omerkilic-0/akilli_sera/README.md

# Akıllı Sera

Bu proje 2023-2024 yılında Tavşanlı MYO Bilgisayar Programcılığı Programı Mikroişlemciler dersin Kadir Ocak, Ömer Kılıç ve Kerim Sarı isimli 3 öğrenci tarafından geliştirilmiştir. 

Proje temel olarak elektrik ihtiyacını güneş paneli sayesinde yenilenebilir enerjiden sağlayarak çalışmakta olup, sulama ve havalandırma işlemlerini tamamen otonom olarak gerçekleştirebilmektedir. Aynı zamanda geliştirilen Mobil Uygulama sayesinden canlı veriler görüntülenebilir ve sera kontrol edilebilir durumda olacaktır.

# Projeyi Hayata Geçirme

Gerekli olan komponentleri tedarik ettikten sonra adımları takip ederek projeyi çalışabilir hale getirebilirsiniz.

## 1. Adım - Komponentler

### Kullanılan Teknolojiler

**İstemci:** Arduino Ekosistemi, ESP32 geliştirme kartı

**Sunucu:** FireBase, MIT APP INVENTOR

## Komponentler

- Ardunio UNO
- 2x16 LCD Ekran
- Mini Dalgıç Su Pompası
- DHT11 Sıcaklık ve Nem Sensörü
- Toprak Nem Sensörü | 2 adet
- BradeBorad | Orta Boy
- ESP32 wroom | Dev Modül
- 10K Potansiyometre
- Ortec 25W Güneş Paneli
- Akü Şarj Cihazı PWM Marka
- 12V 7A Akü
- Erkek-Erkek Jumper | 40 Adet
- Dişi-Dişi Jumper | 40 Adet
- Dişi-Erkek Jumper | 80 Adet
- 10K Direnç | 10 Adet
- LDR Işık Sensörü
- Push Buton | 3 Adet
- Switch Buton | 2 Adet
- 5V Röle | 3 Adet
- Buzzer
- Kırmızı LED
- Fan
- UV LED
- Şipşak Anahtar
- Su Hortumu
- Kablo Kanalı | 35cm
- Lehim Teli
- Havya
- 
## 2. Adım - Devreyi Kurma

Devre şemasına bağlı kalarak devreyi kurun. Kırmızı renk (+) ve siyah renk (-)' yi temsil etmektedir.



## 3. Adım - FireBase' yi oluşturun

Gösterildiği dizinde Web API' nizi oluşturun.

```
FireBase
├── bMod
├── dDOrani
├── fan
├── gMiktari
├── hIsisi
├── hINem
├── kontrol
├── led
├── sDurumu
└── tNOrani
```



## 4. Adım - Kodu Yazma

FireBase nizi oluşturduktan sonra ESP32 kodu üzerinde "..." olarak bırakılan bölgeye WİFİ adı ve Şifreiniz daha sonra FireBase URL ve Şifrenizi yazın.

Arduino yu bilgisayrınıza bağladıktan Arduino İde aracılığı ile Board ve Port ayarlarını yaparak arduino.ino kodunu yazın.

ESP32 yi bilgisayrınıza bağladıktan sonra Arduino İde aracılığı ile gerekli Driverleri kurduktan sonra Board ve Port ayarlarını yaparak esp32.ino kodunu yazın.

## 5. Adım - Mobil Uygulamayı Hazırlama

MIT APP Inventor ile hazırlamış olduğumuz Mobil Uygulamamızın görselleri alt kısımda bulunmaktadır. Kendi zevkinize göre tasarlayabilir veya mobil.apk dosyası üzerinden uygulamamıza göz atabilirsiniz.

### Açılış Sayfası



### Ana Sayfa



### Kontrol Paneli



# Kapanış

Tebrikler. Tüm adımları uyguladınız ve Akıllı Seranız aktif olarak çalışmaktadır. Fakat bu projenin konsept bir proje olduğu unutulmamalı ve geliştirilebilecek birçok noktası bulunduğunu unutmayın. Eğer projemize katkıda bulunur iseniz çok sevinizir.

## Sera Genel Görüntüsü


## Küç Kaynağı Sistemi



## Sensörler ve Motorlar





## Kontrol Paneli




## geliştirilebilecek Noktalar

- Mobil Uygulama ile sera yönetim işlemleri eklenebilir. 
- Seranın veya Mobil Uygulamanın UI ve UX geliştirilmesi yapılabilir.
