omerkilic-0/akilli_sera/Akıllı Sera Proje Raporu.pdf

Kerim SARI | Ömer KILIÇ | Kadir OCAK

Akıllı Sera

# Proje Adı

## Akıllı Sera

# Takım Adı

## KÖK

# Takım Üyeleri

| | ADI | SOYADI | E-POSTA ADRESİ | Öğrenci No
1 | Takım Lideri | Kerim | Sarı | kerim.sari0@ogr.dpu.edu.tr | 202233521005
2 | Takım Üyesi | Ömer | Kılıç | omer.kilic5@ogr.dpu.edu.tr | 202233521028
3 | Takım Üyesi | Kadir | Ocak | kadir.ocak@ogr.dpu.edu.tr | 202233521040

## İçindekiler

# Giriş

Bu proje 2023-2024 eğitim yılında Tavşanlı MYO Bilgisayar Programcılığı Programı Mikroişlemciler dersinde 3 öğrencisi tarafından geliştirilmiştir.
“Akıllı Sera” isimli projemizin temel amacı ekosistem içerisinde bulunan sensörler aracılığı ile ölçümleri otomatik şekilde gerçekleştirerek sulama ve havalandırma işlemlerini otomatik olarak gerçekleştiren, kontrol paneli aracılığı ile kontrollerin yapıldığı ve aynı zamanda geliştirilen mobil uygulama tarafından sera ve bitki durumlarını anlık ve canlı olarak görüntüleyebilecek ve yönetebilecektir. Aynı zamanda yönetim sisteminde bulunan akü, akü şarj cihazı ve güneş paneli sayesinde ihtiyacı olan tüm elektrik gücünü kendisi oluşturarak maliyet azaltma ve karbon ayak izini azaltma gibi küresel problemlere de uyum sağlamaktadır.
Proje geliştirmesinde genel bir görev dağılımı yapılmış olsa da süreç içerisinde çoğu çalışma toplu olarak yapılmıştır.
Projeyi hayata geçirmek için 12. sayfada bulunan “Proje Uygulama” Başlığında verilen GitHub reposuna göz atabilirsiniz.

# Görev Dağılımı

Ömer Kılıç | Arduino ve ESP32 kodlaması(Fiziksel Geliştirme)
Kerim Sarı | Güneş Paneli ve Akü Bağlantıları, Mobil Uygulama Tasarımı ve Kodlaması
Kadir Ocak | Literatür Araştırmaları, Malzeme tedariği ve Rapor Yazımı

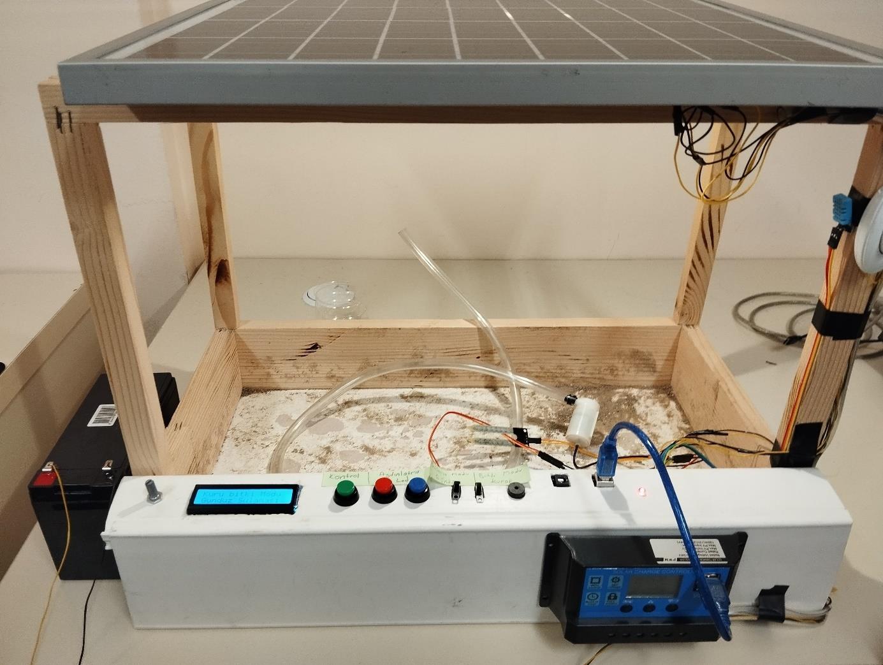
[picture p1: figure]

Sera Görseli

# 4.Hafta

Proje konusunun belirlenmesi ile birlikte kaynakça olabilecek ve yol gösterebilecek projeler aramaya ve incelemeye başladık.

## Bağlantılar

- https://www.instructables.com/WATERING-SYSTEM-INTRODUCTION/
- https://www.youtube.com/watch?v=Wx1Vi0EPhQU
- https://www.youtube.com/watch?v=kue2ZfBctPs&t=1049s
- https://www.youtube.com/watch?v=j9KcTOzwV3s
- https://www.youtube.com/watch?v=gD8AJ-uuhNI
- https://www.youtube.com/watch?v=817StfP5-Lc
- https://www.youtube.com/watch?v=827kfpfIoNA
- https://www.youtube.com/watch?v=JCN8QED31VQ
- https://www.youtube.com/watch?v=nU0ATB06-mQ&t=370s
- https://www.youtube.com/watch?v=70S4YRyMYgo
Araştırmalarımız ve hevesimiz sonucunda akıllı sera projesi yapmaya karar verdik.

# 5.Hafta

Araştırmalarımız sonucunda hangi kaynakça ile yola çıkacağımıza karar verdik.
- https://www.youtube.com/watch?v=kue2ZfBctPs&t=1049s
- https://maker.robotistan.com/arduino-ile-otomatik-sera/

## Malzeme Listesi

- Arduino UNO R3 Klon
- 2x16 LCD Ekran
- Mini Dalgıç Su Pompası 6v
- 2 kanal 2v Röle Kartı
- Su Seviyesi/Yağmur Sensörü
- DHT11 Sıcaklık ve Nem Sensörü
- Toprak Nemi Algılama Sensörü
- 80x80x25mm fan
- IRFZ44 – 49A 55V Mosfet
- IC205 180 Derece Sürgülü Siviç
- IC177 Mavi Push Buton
- 10mm LDR
- 10K Direnç
- 10k Potansiyometre

## Bağlantı Şeması

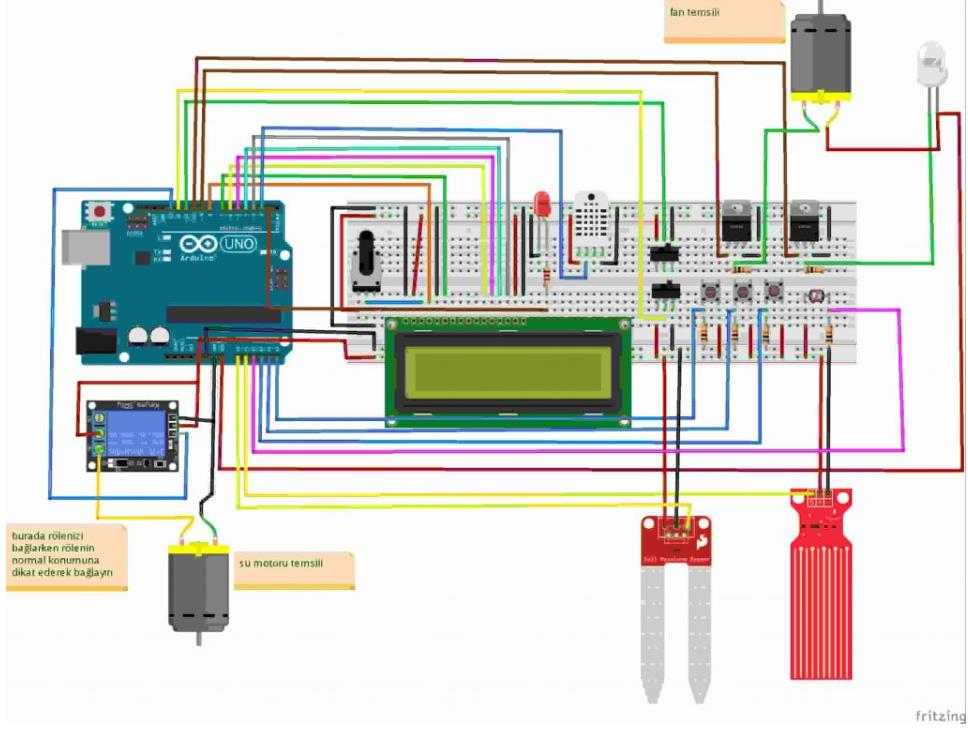
[picture p2: figure]

Proje tanıtım videosu ve dokümanında istenen tüm malzemeler tedarik etmeye başladık.

# 6.Hafta

Kaynakçada istenen tüm komponentler tedarik edildikten sonra dokümanda paylaşıldığı şemaya uyarak devreyi kurduk. Pin bağlantılarını doğru yaptığımızdan emin olduktan sonra paylaşılan kodu Arduino UNO ya yükledik. Hem fiziki hem de Serial Port aracılığı ile testlere başladık. Denemeler esnasında devrenin video anlatıldığı gibi çalışmadığını görerek sorunu aramaya başladık. Sorunun Mosfet ve Rölenin bağlantı ve kullanımında olduğunu düşünerek devreyi elden geçirmeye karar verdik.
Aynı zamanda seramızın kendi elektrik ihtiyacını kendisi karşılamasını istediğimiz için Panel, Akü Şarj Cihazı ve Akü araştırmaya başladık. Araştırmalarımız sonucunda 25W Güneş Paneli, 12V-24V 10A Akü Şarj Cihazı ve 12V 7A Akü kullanma kararı aldık.

## Elektrik Komponentleri

- https://www.n11.com/urun/ortec-gunes-paneli-25-watt-solar-panel-4064374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 (https://www.n11.com/urun/ortec-gunes-paneli-25-watt-solar-panel-4064374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)
- https://www.n11.com/urun/solar-gunes-paneli-aku-sarj-kontrol-cihazi-10-amper-12v-24v-4064413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 (https://www.n11.com/urun/solar-gunes-paneli-aku-sarj-kontrol-cihazi-10-amper-12v-24v-4064413)
- https://www.n11.com/urun/ttec-12-volt-7-a-aku-12v-7-ah-kuru-base-aku-haziran-2023-uretim-8334219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 (https://www.n11.com/urun/ttec-12-volt-7-a-aku-12v-7-ah-kuru-base-aku-haziran-2023-uretim-8334219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)

İhtiyacımız olan komponentleri tedarik etmeye başladık.

# 7.Hafta

Hata ile karşılaşmamız sonucunda tekrar araştırma ve planlamalar başladık. İlk önce hangi özellikleri ve sensörleri kullanmak istediğimize karar verdik.

## Yapmak İstediğimiz Özellikler

- Su deposunun doluluk oranını görüntüleme ve takip etme
- Toprak nem miktarını görüntüleme ve takip etme
- Hava ısı durumunu görüntüleme ve takip etme
- Hava nem durumunu görüntüleme ve takip etme
- Havalandırma için 2 adet fan çalıştırma
- Güneş ışığı miktarını takip etme
- Led iç aydınlatma
- LCD ekran da uyarı ve güncel bilgilerin görüntülenmesi
- Fiziki kontrol paneli aracılığı ile sera kontrolü
- Mobil uygulama ile güncel durum görüntüleme ve sera yönetimi

## Kullanmayı Planladığımız Sensörler ve Bileşenler

- DHT11 Isı ve Nem Sensörü
- LDR Işık Sensörü
- Toprak Nem Sensörü
- Yükseltici Modül Kartı
- Röle
- LCD Ekran
- Potansiyometre
- 3 Adet Push Buton
- 2 Adet Switch Buton
- 1 Adet Buzzer
- 1 Adet Kırmızı Led
- Arduino UNO R3
- BradeBoard
- Jumper türleri
Eksik olan komponentleri tedarik etmeye başladık.

# 10. Hafta

Eksik malzemelerimizin tamamlanması ile devreyi yeniden kurduk ve Mosfet yerine Röle, 1 fan yerine 2 fan ve farklı bir led ile bağlantılarımızı değiştirdik.

## Devremizin Pin Şeması

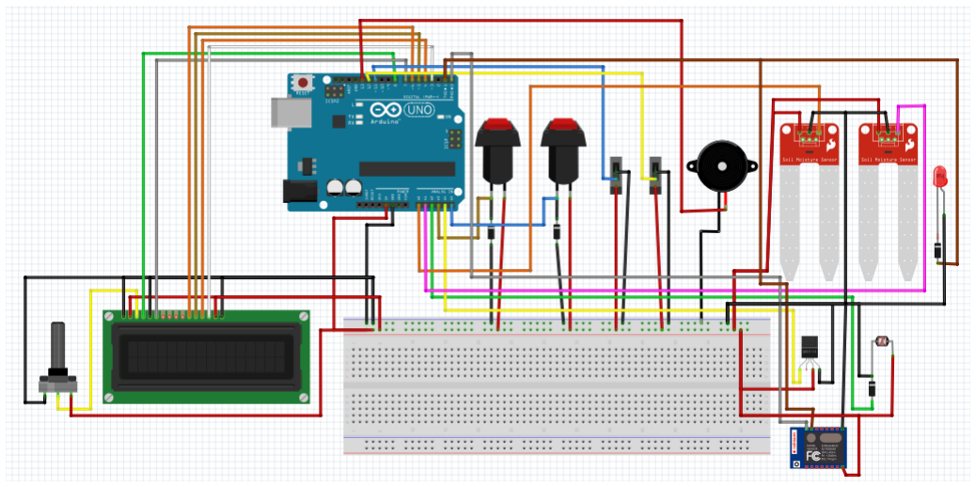
[picture p3: figure]

Devreyi kurduktan sonra planladığımız devre kutusunun içerisine yerleştirmeye başladık ve seranın kontrol panelini oluşturmuş olduk. Kaynakçada paylaşılan kodu düzenleyerek sistemi çalışır hale getirdik. Ardından seranın otomasyon işlemlerinin olmasını istediğimiz için yeni akış diyagramını kurmaya başladık.

## Akış Diyagramı

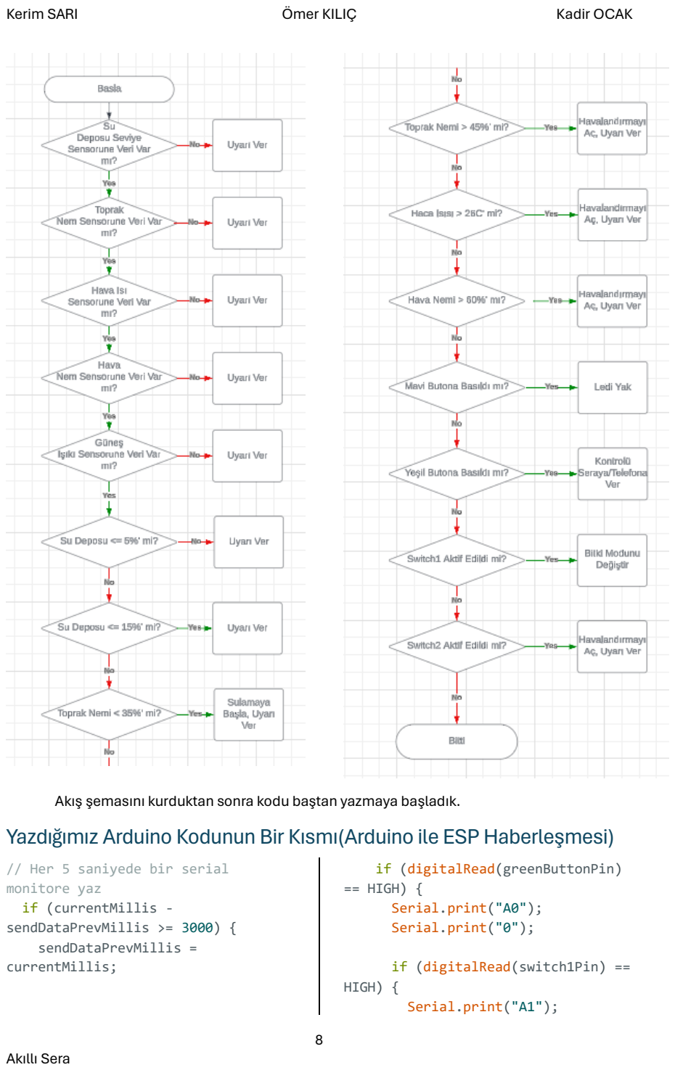
[picture p4: page 8]

Akış şemasını kurduktan sonra kodu baştan yazmaya başladık.

## Yazdığımız Arduino Kodunun Bir Kısmı(Arduino ile ESP Haberleşmesi)

// Her 5 saniyede bir serial
monitore yaz
if (currentMillis -
sendDataPrevMillis >= 3000) { sendDataPrevMillis =
currentMillis;

if (digitalRead(greenButtonPin) == HIGH) {
Serial.print("A0");
Serial.print("0");

if (digitalRead(switch1Pin) == HIGH) {
Serial.print("A1");

Serial.print("0");
} else {
Serial.print("A1");
Serial.print("1");
}

if (digitalRead(switch2Pin) == HIGH) {
Serial.print("A2");
Serial.print("0");
} else {
Serial.print("A2");
Serial.print("1");
}
} else {
Serial.print("A0");
Serial.print("1");

if (digitalRead(switch1Pin) == HIGH) {
Serial.print("A1");
Serial.print("0");
} else {
Serial.print("A1");
Serial.print("1");
}

if (digitalRead(switch2Pin) == HIGH) {
Serial.print("A2");
Serial.print("0");
} else {
Serial.print("A2");
Serial.print("1");
}
}

Serial.print("A3");
if (waterTankLevel < 10) { Serial.print("0");
}
Serial.print(waterTankLevel); Serial.print("A4");
if (soilMoisture < 10) {
Serial.print("0");
}
Serial.print(soilMoisture); Serial.print("A5");
Serial.print(temperature); Serial.print("A6");
Serial.print(humidity);
Serial.print("A7");
Serial.print(sunlight);
Serial.println("A8");
}

Kod yazma aşamasında yazdığımız kodun Arduino ya yüklendiğinde çalışmama hatası ile karşılaştık. Uzun uğraşlar sonucu yazdığımız kodun 600 satırdan fazla olmasıyla birlikte Arduino UNO’ nun dinamik belleğinin yetersiz gelme hatası ile karşılaştık. Yazdığımız kodu iyileştirerek hatayı çözerek geliştirmelerimize devam ettik.

## Hata Çıktısı

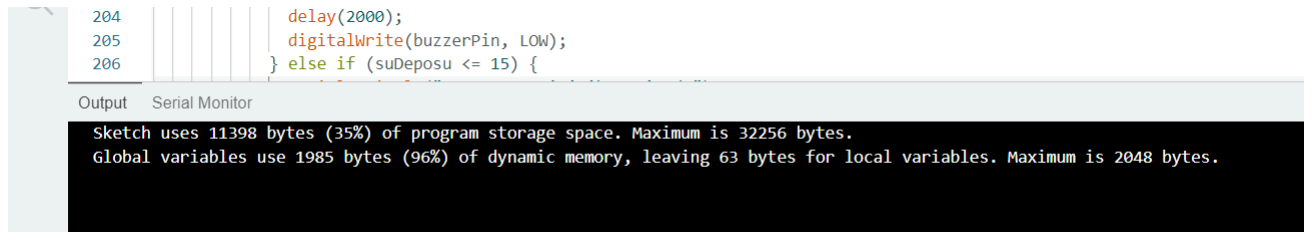
[picture p5: figure]

## Hatanın Çözümünden Sonraki Çıktı

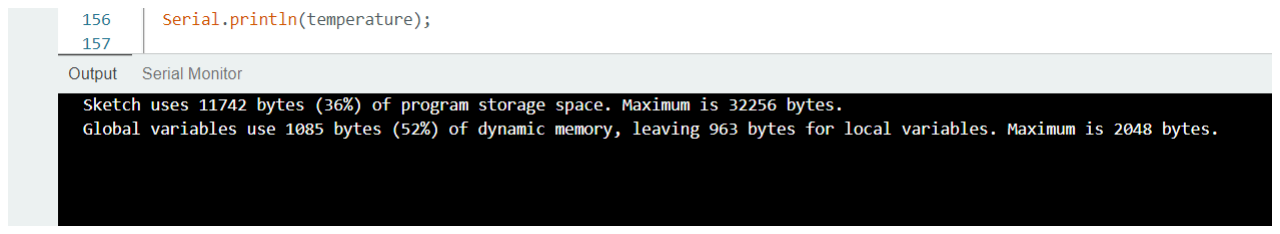
[picture p6: figure]

# 11. Hafta

Kurduğumuz devrenin ve yazdığımız Arduino kodunun fiziki ve Serial Port testlerini gerçekleştirerek devrenin ve kurduğumuz akış diyagramı doğrultusunda yazdığımız kodun çalıştığından emin olduk.
Aldığımız elektrik komponentlerini elimize ulaşması ile bağlantıları gerçekleştirerek Güneş Paneli, Akü Şarj Cihazı ve Akümüzü aktif hale getirerek tüm devrenin güneş enerjisi ile çalışmasını sağladık.
Sera sisteminin tamamlanması ile sıra mobil uygulama ile anlık bilgi görme ve serayı yönetmeye geldi. Önceden planlayarak tedarik ettiğimiz ESP32 kartını nasıl kullanacağımıza, pin bağlantılarına ve kod araştırmaları yapmaya başladık.

# 12. Hafta

Araştırmalarımız sonucunda ESP32 yi nasıl kullanabileceğimize karar verdikten sonra kodlamaya başladık. Arduino ile ESP32 ni RX ve TX pinlerini birbirlerine ters bağlayarak geliştirme kartlarını seri bağlamış olduk. ESP32 nin 5V ve GND pinlerini de Arduino ile bağlamamızın ardından kart bağlantıları tamamlanmış oldu. Serial monitör aracılığı ile Arduino UNO dan aldığımız verileri 3 saniyede bir FireBaseye yazdırmaya başladık.

## ESP32 Kodunun Bir Kısmı

if (Serial.available()) {
String message = Serial.readString();
int startPos = 0;
int endPos = message.indexOf("A", startPos + 1);

while (endPos != -1) {
String subMessage = message.substring(startPos, endPos); String key;
String valueStr;

if (subMessage.startsWith("A0")) {
key = "kontrol";
valueStr = subMessage.substring(2);
} else if (subMessage.startsWith("A1")) { key = "bMod";
valueStr = subMessage.substring(2);
} else if (subMessage.startsWith("A2")) {

key = "sDurumu";
valueStr = subMessage.substring(2);
} else if (subMessage.startsWith("A3")) { key = "dDOrani";
valueStr = subMessage.substring(2);
} else if (subMessage.startsWith("A4")) { key = "tNOrani";
valueStr = subMessage.substring(2);
} else if (subMessage.startsWith("A5")) { key = "hIsisi";
valueStr = subMessage.substring(2);
} else if (subMessage.startsWith("A6")) { key = "hNem";
valueStr = subMessage.substring(2);
} else if (subMessage.startsWith("A7")) { key = "gMiktari";
valueStr = subMessage.substring(2);
}

if (key.length() > 0) {
int valueInt = valueStr.toInt(); // Convert to integer to remove leading zeros
String path = "/realValue/" + key;
if (!Firebase.RTDB.setInt(&fbdo, path.c_str(), valueInt)) { Serial.printf("Error setting %s: %s\n", key.c_str(), fbdo.errorReason().c_str()); }
}
startPos = endPos;
endPos = message.indexOf("A", startPos + 1); }
}

Kod yazma işlemleri bittikten sonra MIT APP Inventor ile mobil uygulamamızı tasarlamaya başladık.

# 13. Hafta

Mobil uygulamamızın tasarımını ve kodlamasını yaptıktan sonra telefon ile yönetim platformu tamamlanmış oldu. Fakat ESP32 ile FireBase ye veri yazma ve veri çekme işlemleri sırasında çekilen verileri Serial Monitor aracılığı ile ESP32 ye aktarırken birçok hata ile karşılaştık. Hatalardan bahsetmek gerekir ise alınan ve gönderilen verilerin çakışması sonucu kodun kısır döngüye girmesi, ESP32 nin stabil olarak yazma ve okuma işlemleri yapamaması ve FireBase nin
3. Taraf bağlantılara engel atması sonucunda mobil uygulamamamızın sadece anlık bilgi görme kısımlarını tamamlamaya ve testlim etmeye karar verdik.

# Projeyi Uygulama

Projeyi kurmak için GitHub üzerindeki readme dosyası üzerinden ve kodlardan detaylara ulaşabilirsiniz.
- https://github.com/omerkilic-0/akilli_sera

# Kullanılan Tüm Komponentler

No | İsim | Adet | Alınan Yer | Ücret
1 | Arduino Uno | 1 | Bahadır Çokçetin | 0
2 | 2x16 lcd ekran | 1 | Bahadır Çokçetin | 0
3 | mini dalgıç pompa 6v | 1 | Bahadır Çokçetin | 0
4 | DHT11Sıcaklık ve nem sensörü | 1 | Bahadır Çokçetin | 0
5 | toprak nemi algılama sensörü | 1 | Bahadır Çokçetin | 0
6 | BreadBoard | 1 | Bahadır Çokçetin | 0
7 | ESP32 | 1 | Bahadır Çokçetin | 0
8 | Potansiyo Metre | 1 | Bahadır Çokçetin | 0
9 | Ortec 25W Güneş Paneli | 1 | N11 | 783
10 | Akü Şarj Cihazı | 1 | N11 | 300
11 | 12V 7A Akü | 1 | N11 | 395
12 | Erkek-Erkek Jumper | 40 | Robo90 | 26
13 | Dişi-Dişi Jumper | 40 | Robo90 | 24
14 | 10K Direnç | 10 | Robo90 | 2
15 | LDR | 2 | Robo90 | 2
16 | Push Buton | 3 | Robo90 | 27
17 | Switch | 2 | Robo90 | 5
18 | Mosfet | 2 | Robo90 | 20
19 | 5V Röle | 1 | Robo90 | 48
20 | Toprak Nem Sensörü | 1 | Robo90 | 24
21 | Dişi-Erkek Jumper | 80 | Robo90 | 50
22 | Buzzer | 1 | Robo90 | 6
23 | Kırmızı Led | 1 | Robo90 | 3
24 | Fan | 2 | Tavşanlı | 30
25 | LED | 1 | Tavşanlı | 45
27 | Şipşak Anahtar | 1 | Tavşanlı | 15
28 | Elektrik Bandı | 1 | Tavşanlı | 15
29 | Su Hortumu | 1 | Tavşanlı | 15
30 | Kablo Kanalı | 1 | Tavşanlı | 40
31 | Elektrik Kablosu | 1 | Tavşanlı | 15
32 | Lehim Teli | 1 | Robotistan | 22
33 | Kargo | 1 | | 45

## Toplam Fiyat: 1957 TL

# Sera Görselleri

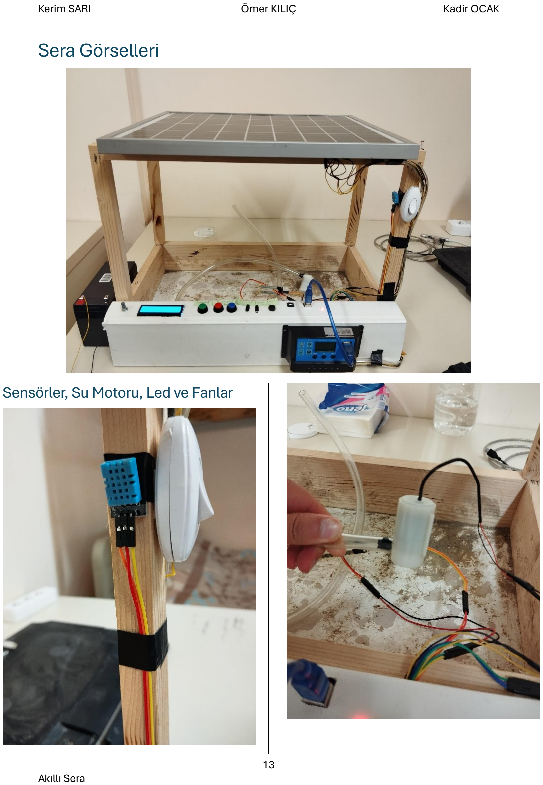
[picture p7: page 13]

## Sensörler, Su Motoru, Led ve Fanlar

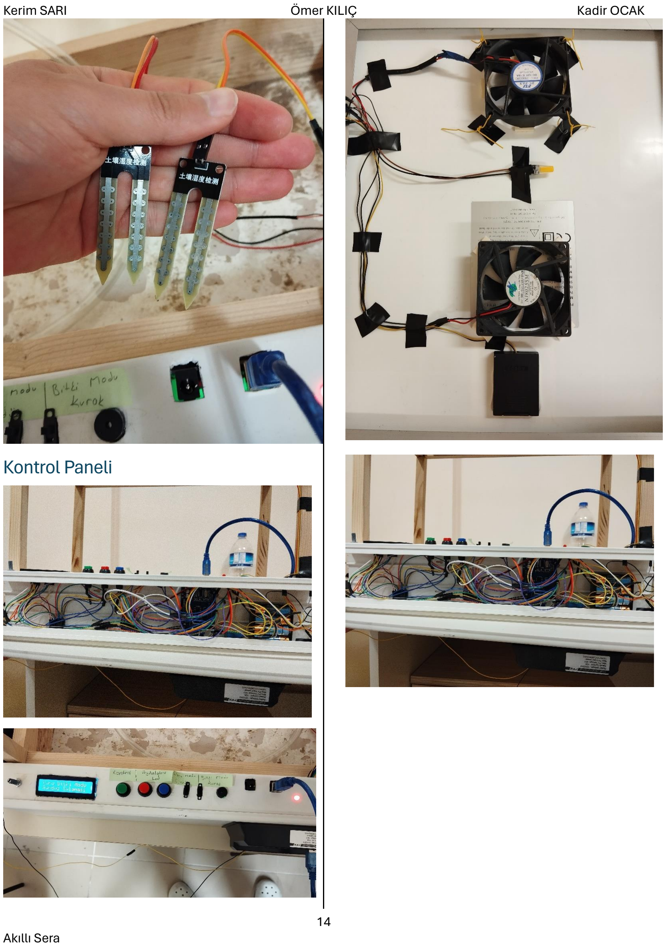
[picture p8: page 14]

## Kontrol Paneli

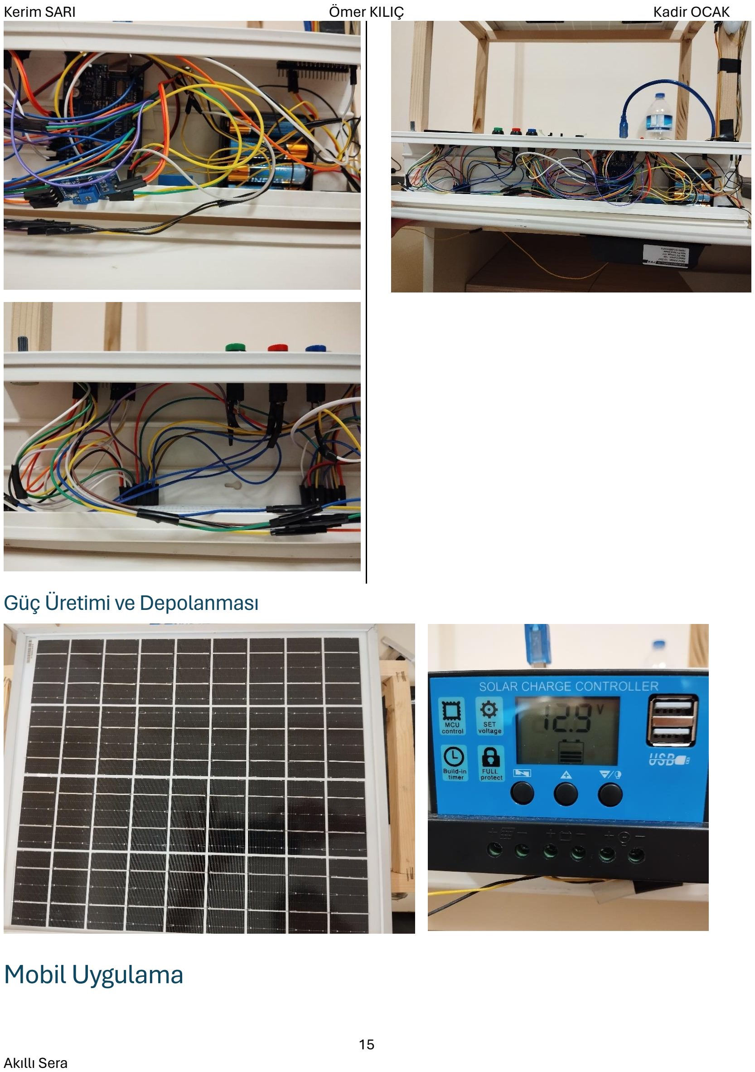
[picture p9: page 15]

## Güç Üretimi ve Depolanması

# Mobil Uygulama

## Arayüz

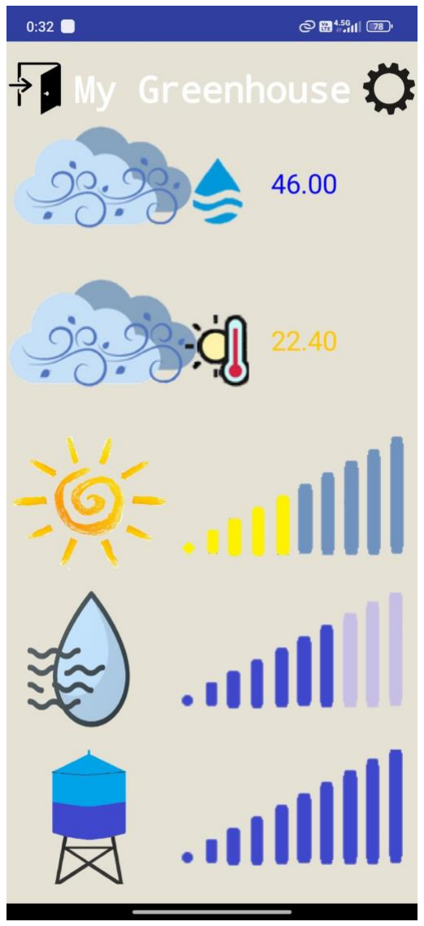
[picture p10: figure]
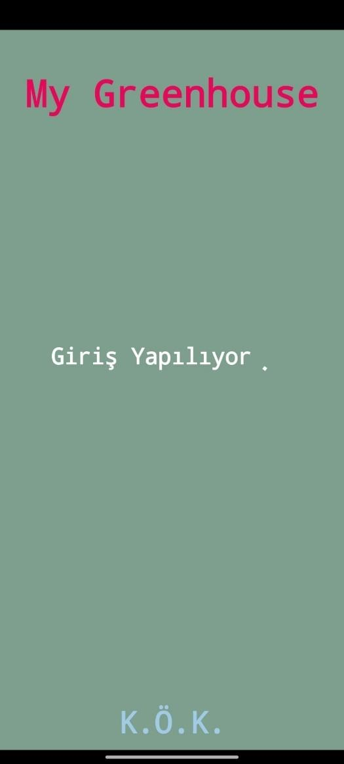
[picture p11: figure]

Giriş Sayfası | Ana Sayfa

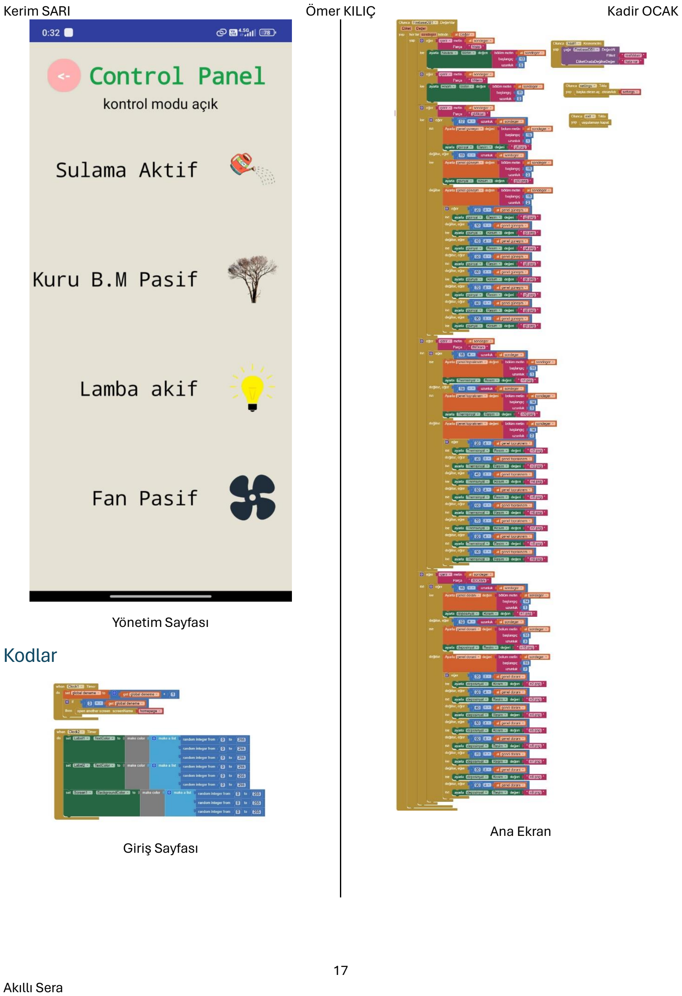
[picture p12: page 17]

Yönetim Sayfası

## Kodlar

Giriş Sayfası

Ana Ekran

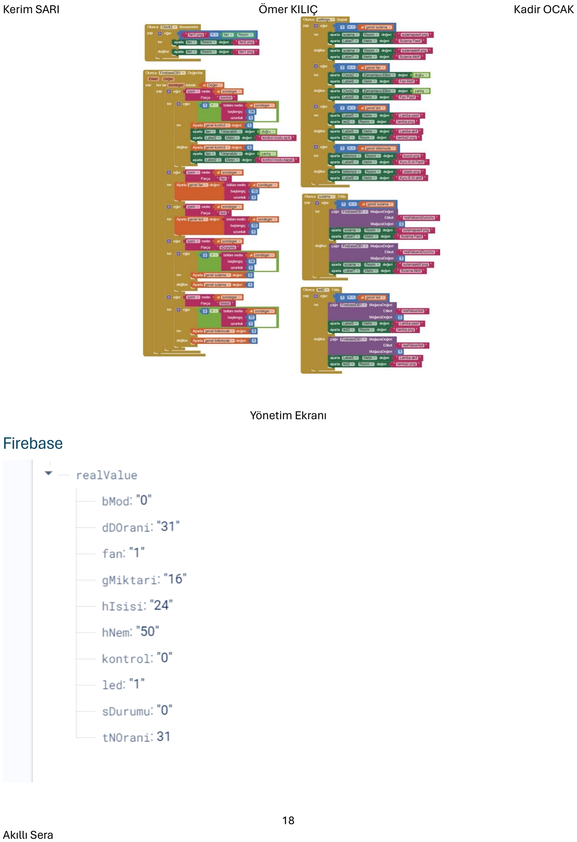
[picture p13: page 18]

Yönetim Ekranı

## Firebase
